vonkratzmann/Yacht_V1/Yacht Circuit Diagram V1.jpg

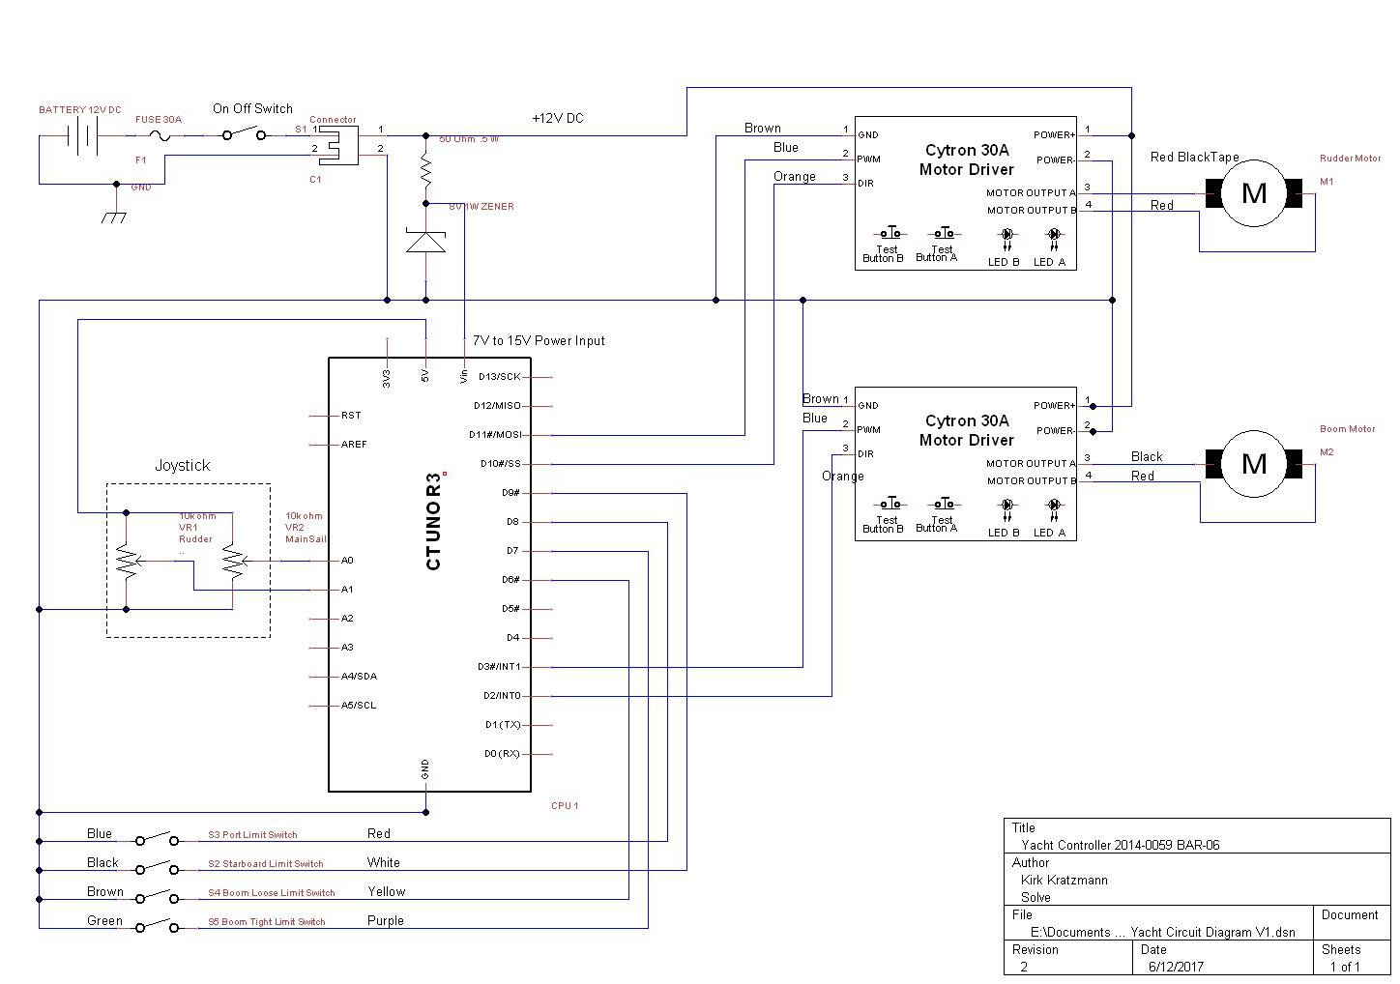
Yacht Circuit Diagram V1.jpg
