vonkratzmann/Yacht_V1/Yacht Circuit Diagram V2 Rotated.jpg

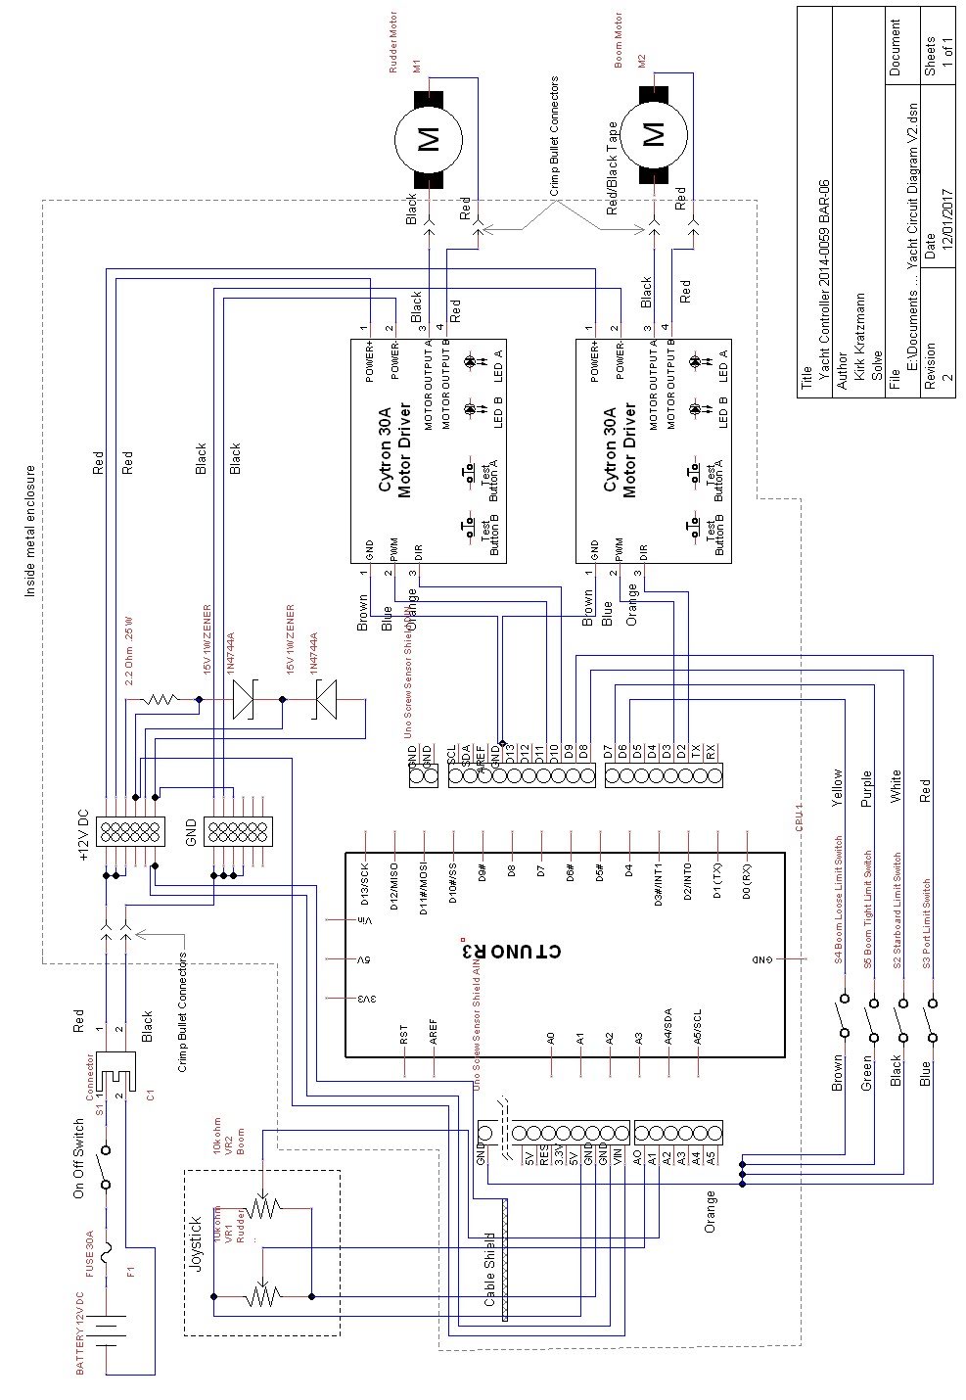
Yacht Circuit Diagram V2 Rotated.jpg
