vonkratzmann/Yacht_V1/Yacht Circuit Diagram V2.png

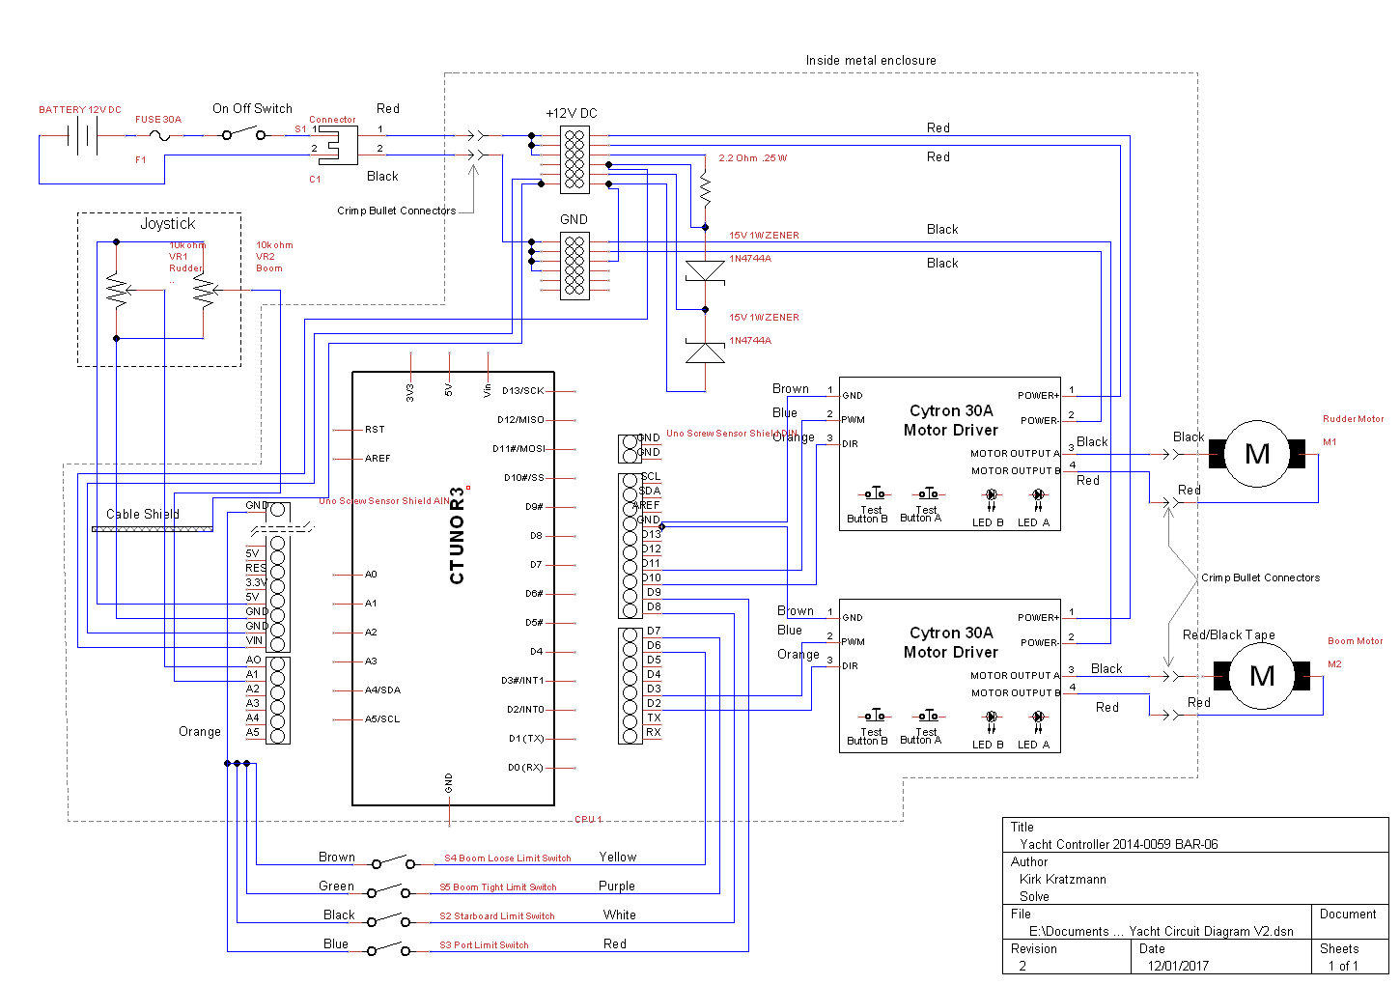
Yacht Circuit Diagram V2.png
