vonkratzmann/Yacht_V1/(list of files, drawings)

Other design files:
Yacht Circuit Diagram V1.dsn
Yacht Circuit Diagram V2.dsn
