vonkratzmann/Yacht_V1/JoyStick.cpp

#include "Yacht.h"
#include "JoyStick.h"

/* JoyStick constructor
     initialses current x and y positions to the centre of the joystick
*/
JoyStick::JoyStick ()
{
  x_Cur = y_Cur = 511;                       //10 bit ADC, forwards 0 to 511,backwards 512 to 1023
  x_New = y_New = 511;                       //set joy stick to center position ie stopped
}

/* JoyStick check x position
    reads joystick, compares current and new
    masks bottom bits to prevent unwanted noise and doing unnecessary processing
    limits rate of change
    returns true if position has changed
*/
bool JoyStick::check_X_Axis (void)               //check joystick for any changes
{
  bool x_Chnged = false;                        //flag joy stick position has changed
  x_New = analogRead(rudder_JoystickAnalogPin); //read joystick x position and put into x_New

  JOYSTICK_DEBUG_X_EQUALS_256                   //if debug is defined, sets a fixed value for x for debugging

  x_New &= noise_Mask;                          //zero bottom bits to prevent unnecessary calls in case of noise on ADC input
  if ( x_Cur != x_New)                          //Check if changed from last read
  {
    x_Chnged = true;                            //yes, set flag to say it has changed

    JOYSTICK_DEBUG_FILE("Function: ");          // if joystick debug defined prints out position of joystick on serial monitor
    JOYSTICK_DEBUG_FILE(__FILE__);
    JOYSTICK_DEBUG_FILE(",");
    JOYSTICK_DEBUG_PRINT(__FUNCTION__);
    JOYSTICK_DEBUG_PRINT(" x_Cur: ");
    JOYSTICK_DEBUG_PRINT(x_Cur);
    JOYSTICK_DEBUG_PRINT(" ");
    JOYSTICK_DEBUG_PRINT("x_New: ");
    JOYSTICK_DEBUG_PRINT(x_New);
    JOYSTICK_DEBUG_PRINT(" ");

    diff = x_New - x_Cur;
    if (abs(diff) > JoyStick_Max_ROC)         //check if difference greater then max rate of change (ROC)
    {
      if (diff > 0)                           //yes, limit max acceleration to max rate of change, check if reading is increasing or decreasing
        x_Cur += JoyStick_Max_ROC;            //reading has gone up,so limit acceleration by adding max rate of change
      else
        x_Cur -= JoyStick_Max_ROC;            //reading has gone down,so limit acceleration by subtracting max rate of change
    }
    else
    {
      x_Cur = x_New;                          // change less than max rate of change, so accept new value
    }

    JOYSTICK_DEBUG_PRINT("updated x_Cur: ");
    JOYSTICK_DEBUG_PRINTLN(x_Cur);

  }
  return x_Chnged;
}

/* JoyStick check y position
   reads joystick, compares current and new
   masks bottom bits to prevent unwanted noise and doing unnecessary processing
   limits rate of change
   returns true if position has changed
*/
bool JoyStick::check_Y_Axis (void)               //check joystick for any changes
{
  bool y_Chnged = false;                        //flag joy stick position has changed
  y_New = analogRead(boom_JoystickAnalogPin);   //read joystick y position and put into y_new

  JOYSTICK_DEBUG_Y_EQUALS_256                  //if debug is defined, sets a fixed value for x for debugging

  y_New &= noise_Mask;                          //zero bottom bits to prevent unnecessary calls in case of noise on ADC input
  if ( y_Cur != y_New)                          //Check if changed from last read
  {
    y_Chnged = true;                             //yes, set flag to say it has changed

    JOYSTICK_DEBUG_FILE("Function: ");          // if joystick debug defined prints out position of joystick on serial monitor
    JOYSTICK_DEBUG_FILE(__FILE__);
    JOYSTICK_DEBUG_FILE(",");
    JOYSTICK_DEBUG_PRINT(__FUNCTION__);
    JOYSTICK_DEBUG_PRINT(" y_Cur: ");
    JOYSTICK_DEBUG_PRINT(y_Cur);
    JOYSTICK_DEBUG_PRINT(" ");
    JOYSTICK_DEBUG_PRINT("y_New: ");
    JOYSTICK_DEBUG_PRINT(y_New);
    JOYSTICK_DEBUG_PRINT(" ");

    diff = y_New - y_Cur;
    if (abs(diff) > JoyStick_Max_ROC)       //check if difference greater then max rate of change (ROC)
    {
      if (diff > 0)                         //yes, limit max acceleration to max rate of change, check if reading is increasing or decreasing
        y_Cur += JoyStick_Max_ROC;          //reading has gone up,so limit acceleration by adding max rate of change
      else
        y_Cur -= JoyStick_Max_ROC;          //reading has gone down,so limit acceleration by subtracting max rate of change
    }
    else
    {
      y_Cur = y_New;                        // change less than max rate of change, so accept new value
    }

    JOYSTICK_DEBUG_PRINT("updated y_Cur: ");
    JOYSTICK_DEBUG_PRINTLN(y_Cur);
  }
  return y_Chnged;
}

/* JoyStick::process_X
   accepts two pointer arguments to allow update of new speed and direction
   checks if its in stopped range, if yes sets speed to zero
   else checks requested direction and updates direction
   then scales the new speed bewteen the min and max speeds based on joystick position
*/
void JoyStick::process_X(int *new_Spd, int *new_Dir)            //process change for x axis of joystick
{
  if (x_Cur <= Stopped_High && x_Cur >= Stopped_Low)            //check if in the stopped range
  {
    *new_Spd = 0;                                               //yes, stopped so update speed to say stopped

 /* Note direction is not set when at stop position, leave unchanged to prevent unexpected change of direction just before the motor stops. 
    This occurs because of the difference between the Motor_Max_ROC and the Joystick_Max_ROC. Probable they could be the same value. */
 
    JOYSTICK_DEBUG_FILE("Function: ");
    JOYSTICK_DEBUG_FILE(__FILE__);
    JOYSTICK_DEBUG_FILE(",");
    JOYSTICK_DEBUG_PRINT(__FUNCTION__);
    JOYSTICK_DEBUG_PRINT("(stopped) ");
    JOYSTICK_DEBUG_PRINT("new_Spd: ");
    JOYSTICK_DEBUG_PRINT(*new_Spd);
    JOYSTICK_DEBUG_PRINT(" new_Dir: ");
    JOYSTICK_DEBUG_PRINTLN(*new_Dir);
  }
  else                                                          //no, joystick requesting movement
  {
    if (x_Cur < Stopped_Low)                                    //is joystick asking to move to port
    {
      *new_Dir = TOSTARBOARD;                                        //yes, moving to starboard
      *new_Spd = map(x_Cur, Stopped_Low - 1, 0, MINSPEED, MAXSPEED); //Scale joystick position to speed range for motor

      JOYSTICK_DEBUG_FILE("Function: ");
      JOYSTICK_DEBUG_FILE(__FILE__);
      JOYSTICK_DEBUG_FILE(",");
      JOYSTICK_DEBUG_PRINT(__FUNCTION__);
      JOYSTICK_DEBUG_PRINT("(low) ");
      JOYSTICK_DEBUG_PRINT("new_Spd: ");
      JOYSTICK_DEBUG_PRINT(*new_Spd);
      JOYSTICK_DEBUG_PRINT(" ");
      JOYSTICK_DEBUG_PRINT("new_Dir: ");
      JOYSTICK_DEBUG_PRINTLN(*new_Dir);
    }
    else                                                        //no, request to move to port
    {
      *new_Dir = TOPORT;
      *new_Spd = map(x_Cur, Stopped_High + 1, 1023, MINSPEED, MAXSPEED); //Scale joystick position to speed range for motor

      JOYSTICK_DEBUG_FILE("Function: ");
      JOYSTICK_DEBUG_FILE(__FILE__);
      JOYSTICK_DEBUG_FILE(",");
      JOYSTICK_DEBUG_PRINT(__FUNCTION__);
      JOYSTICK_DEBUG_PRINT("(high) ");
      JOYSTICK_DEBUG_PRINT("new_Spd: ");
      JOYSTICK_DEBUG_PRINT(*new_Spd);
      JOYSTICK_DEBUG_PRINT(" ");
      JOYSTICK_DEBUG_PRINT("new_Dir: ");
      JOYSTICK_DEBUG_PRINTLN(*new_Dir);
    }
  }
}
/* JoyStick::process_Y
   accepts two pointer arguments to allow update of new speed and direction
   checks if its in stopped range, if yes sets speed to zero
   else checks requested direction and updates direction
   then scales the new speed bewteen the min and max speeds based on joystick position
*/
void JoyStick::process_Y(int *new_Spd, int *new_Dir)            //process change for Y axis of joystick
{
  if (y_Cur <= Stopped_High && y_Cur >= Stopped_Low)            //check if in the stopped range
  {
    *new_Spd = 0;                                               //yes, stopped so update speed to say stopped
 
 /* Note direction is not set when at stop position, leave unchanged to prevent unexpected change of direction just before the motor stops. 
    This occurs because of the difference between the Motor_Max_ROC and the Joystick_Max_ROC. Probable they could be the same value. */
 
    JOYSTICK_DEBUG_FILE("Function: ");
    JOYSTICK_DEBUG_FILE(__FILE__);
    JOYSTICK_DEBUG_FILE(",");
    JOYSTICK_DEBUG_PRINT(__FUNCTION__);
    JOYSTICK_DEBUG_PRINT("(stopped) ");
    JOYSTICK_DEBUG_PRINT("new_Spd: ");
    JOYSTICK_DEBUG_PRINT(*new_Spd);
      JOYSTICK_DEBUG_PRINT(" new_Dir: ");
      JOYSTICK_DEBUG_PRINTLN(*new_Dir);
  }
  else                                                          //no, joystick requesting movement
  {
    if (y_Cur < Stopped_Low)                                    //is joystick asking to tighten the ripe to the boom
    { //yes
      *new_Dir = TIGHTENING;                                    //yes, tightening rope to boom
      *new_Spd = map(y_Cur, Stopped_Low - 1, 0, MINSPEED, MAXSPEED); //Scale joystick position to speed range for motor

      JOYSTICK_DEBUG_FILE("Function: ");
      JOYSTICK_DEBUG_FILE(__FILE__);
      JOYSTICK_DEBUG_FILE(",");
      JOYSTICK_DEBUG_PRINT(__FUNCTION__);
      JOYSTICK_DEBUG_PRINT("(low) ");
      JOYSTICK_DEBUG_PRINT("new_Spd: ");
      JOYSTICK_DEBUG_PRINT(*new_Spd);
      JOYSTICK_DEBUG_PRINT(" ");
      JOYSTICK_DEBUG_PRINT("new_Dir: ");
      JOYSTICK_DEBUG_PRINTLN(*new_Dir);
    }
    else                                                        //no, request to move to loosen the rope to the boom
    {
      *new_Dir = LOOSENING;
      *new_Spd = map(y_Cur, Stopped_High + 1, 1023, MINSPEED, MAXSPEED); //Scale joystick position to speed range for motor

      JOYSTICK_DEBUG_FILE("Function: ");
      JOYSTICK_DEBUG_PRINT(__FUNCTION__);
      JOYSTICK_DEBUG_FILE(",");
      JOYSTICK_DEBUG_FILE(__FILE__);
      JOYSTICK_DEBUG_PRINT("(high) ");
      JOYSTICK_DEBUG_PRINT("new_Spd: ");
      JOYSTICK_DEBUG_PRINT(*new_Spd);
      JOYSTICK_DEBUG_PRINT(" ");
      JOYSTICK_DEBUG_PRINT("new_Dir: ");
      JOYSTICK_DEBUG_PRINTLN(*new_Dir);
    }
  }
}
