vonkratzmann/Yacht_V1/(commit log)

2017-11-27 added switch code
2017-11-27 fixed bug in switch debounce
    [Switch.cpp, Switch.h, Yacht_V1.ino]
2017-11-29 first working version in x axis
2017-11-29 initial code to stop when hit limit switches
2017-11-29 completed code to stop when hit limit switches
2017-11-30 new pwm code which does not use arduino analogWrite
2017-11-30 tidy up some commnents and disabled all serial print debuggig to console
2017-12-01 added more comments to the code and added flash to diagnostic led if reed switch change detected
2018-01-19 Update study pc
    [Yacht Circuit Diagram V1.dsn, Yacht Circuit Diagram V2.dsn]
